NickTheWhale/lora-tracker/README.md

# lora-tracker
digikey cart: http://www.digikey.com/short/pwb05w9p
