NickTheWhale/lora-tracker/schematic gps.brd

## EAGLE design schematic gps.brd (2022-03-09)

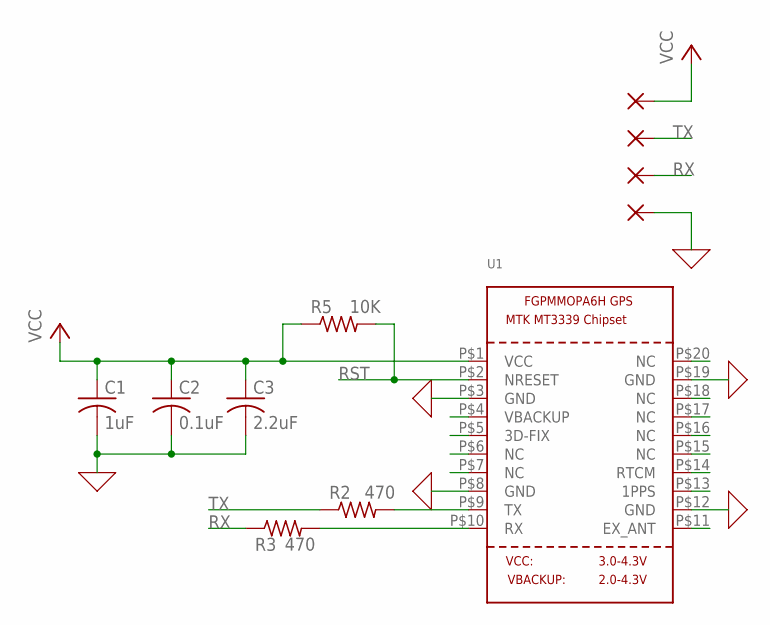
[picture p1: schematic schematic gps.sch]

Parts:
C1: 1uF; C0805
C2: 0.1uF; C0805
C3: 2.2uF; C0805
GND: WIREPADSMD1,27-254; SMD1,27-2,54
R2, R3: 470; R0805
R5: 10K; R0805
RX: WIREPADSMD1,27-254; SMD1,27-2,54
TX: WIREPADSMD1,27-254; SMD1,27-2,54
U1: GPS_FGPMMOPA6H; FGPMMOPA6H
VCC: WIREPADSMD1,27-254; SMD1,27-2,54

Connections:
0: C1.2, C2.2, C3.2, GND.1, U1.P$3 (GND), U1.P$8 (GND), U1.P$12 (GND), U1.P$19 (GND)
unnamed: R2.2, U1.P$9 (TX)
unnamed: R3.2, U1.P$10 (RX)
RST: R5.2, U1.P$2 (NRESET)
RX: R3.1, RX.1
TX: R2.1, TX.1
VCC: C1.1, C2.1, C3.1, R5.1, U1.P$1 (VCC), VCC.1

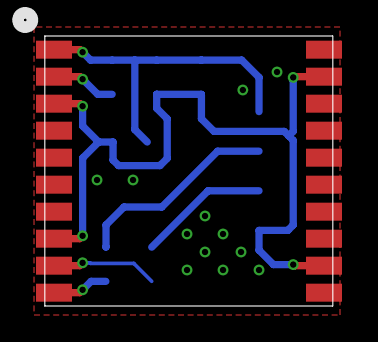
[picture p2: board schematic gps.brd from above]

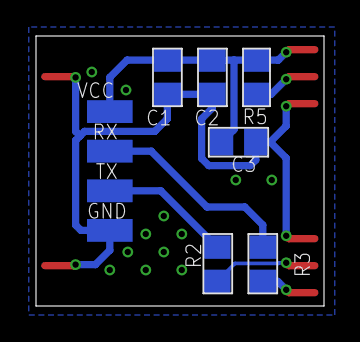
[picture p3: board schematic gps.brd from below]

Board: 2 copper layers, 16.0 x 15.0 mm, 11 parts (10 on the bottom side), 7 nets.
