NickTheWhale/lora-tracker/schematic.brd

## EAGLE design schematic.brd (2022-03-08)

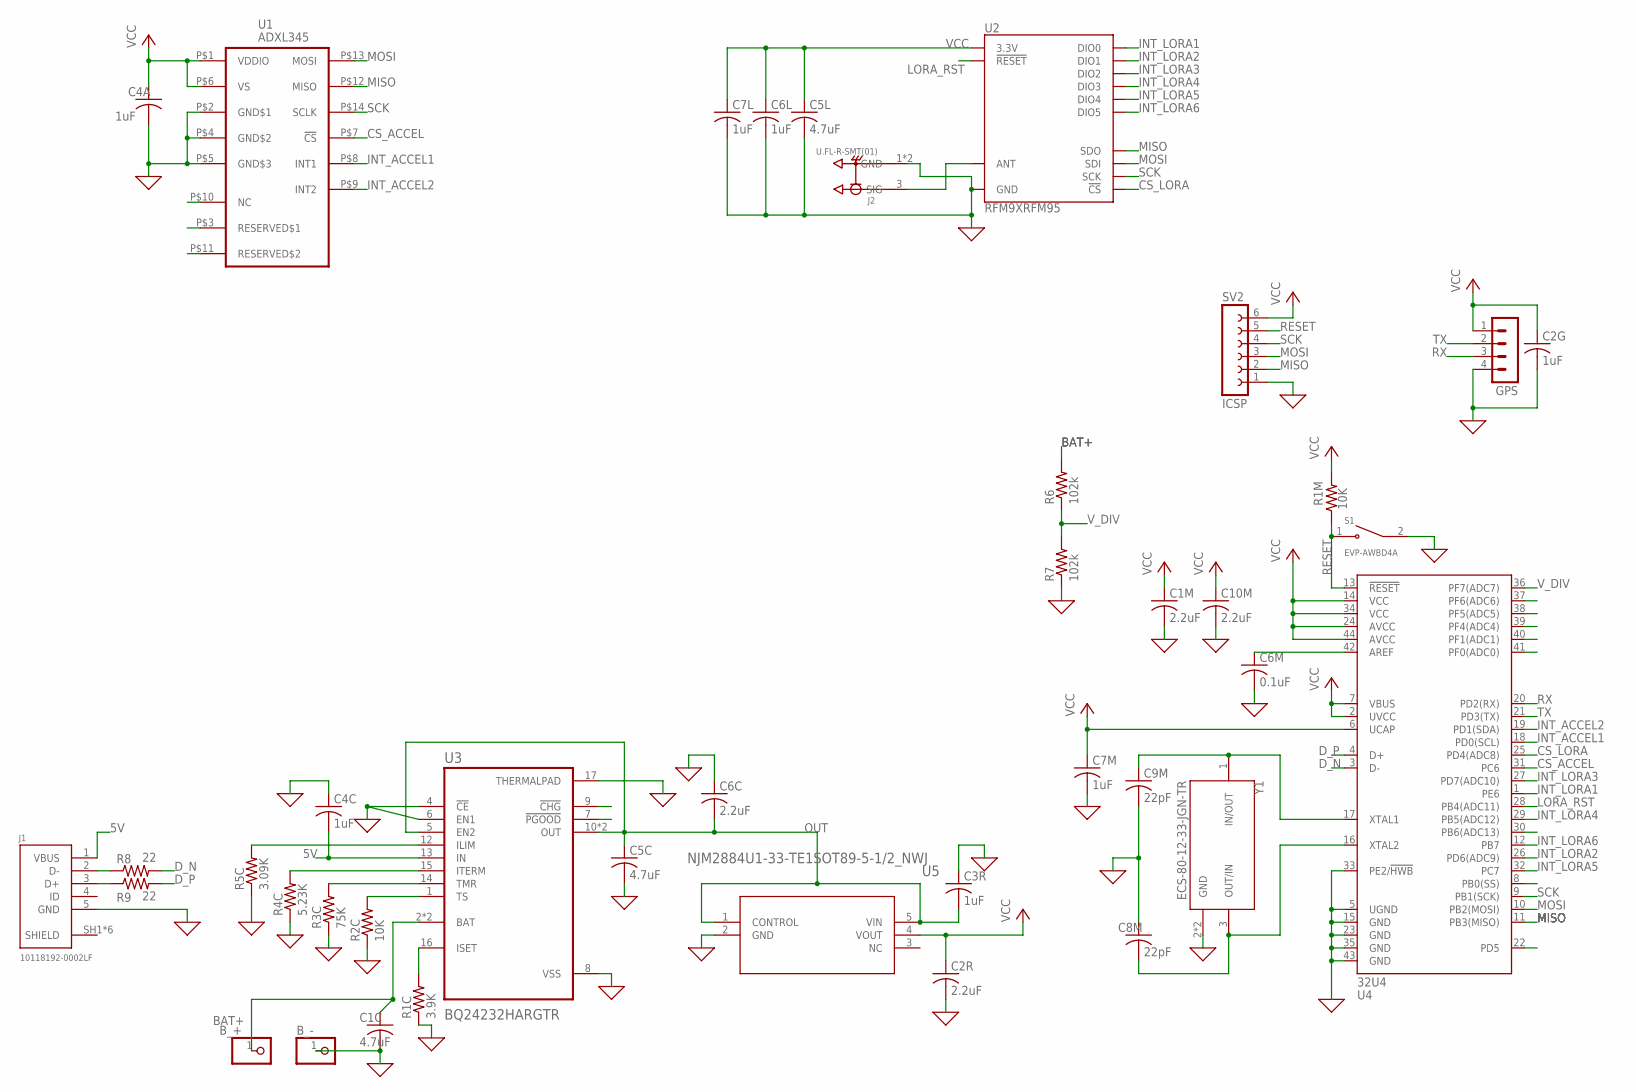
[picture p4: schematic schematic.sch]

Parts:
B_+: PINHD-1X1; 1X01
B_-: PINHD-1X1; 1X01
C1C, C5C, C5L: 4.7uF; C0805
C1M, C2R, C6C, C10M: 2.2uF; C0805
C2G, C3R, C4A, C4C, C6L, C7L, C7M: 1uF; C0805
C6M: 0.1uF; C0805
C8M, C9M: 22pF; C0805
GPS: MA04-1
J1: 10118192-0002LF
J2: U.FL-R-SMT(01); HRS_U.FL-R-SMT(01)
R1C: 3.9K; R0805
R1M, R2C: 10K; R0805
R3C: 75K; R0805
R4C: 5.23K; R0805
R5C: 3.09K; R0805
R6, R7: 102k; R0805
R8, R9: 22; R0805
S1: EVP-AWBD4A; SW_EVP-AWBD4A
SV2: ICSP; FE06
U1: ADXL345; LGA14
U2: RFM9XRFM95; RFM95
U3: BQ24232HARGTR; QFN50P300X300X100-17N
U4: 32U4; QFN-44
U5: NJM2884U1-33-TE1SOT89-5-1/2_NWJ; SOT89-5-1/2_NWJ
Y1: ECS-80-12-33-JGN-TR; XTAL_ECS-240-8-33-AGN-TR

Connections:
0: B_-.1, C1C.2, C1M.2, C2G.2, C2R.2, C3R.1, C4A.2, C4C.1, C5C.2, C5L.2, C6C.1, C6L.2, C6M.2, C7L.2, C7M.2, C8M.1, C9M.2, C10M.2, GPS.4, J1.5 (GND), J2.1 (GND), J2.2 (GND), R1C.1, R2C.1, R3C.1, R4C.1, R5C.1, R7.1, S1.2 (COM), SV2.1, U1.P$2 (GND$1), U1.P$4 (GND$2), U1.P$5 (GND$3), U2.GND@1 (GND), U2.GND@2 (GND), U2.GND@3 (GND), U3.4 (!CE), U3.6 (EN1), U3.8 (VSS), U3.17 (THERMALPAD), U4.5 (UGND), U4.15 (GND), U4.23 (GND), U4.33 (PE2/!HWB), U4.35 (GND), U4.43 (GND), U5.2 (GND), Y1.2 (GND), Y1.4 (GND)
5V: C4C.2, J1.1 (VBUS), U3.13 (IN)
BAT+: B_+.1, C1C.1, R6.2, U3.2 (BAT), U3.3 (BAT)
CS_ACCEL: U1.P$7 (!CS), U4.31 (PC6)
CS_LORA: U2.NSS (!CS!), U4.25 (PD4(ADC8))
D_N: R8.2, U4.3 (D-)
D_P: R9.2, U4.4 (D+)
INT_ACCEL1: U1.P$8 (INT1), U4.18 (PD0(SCL))
INT_ACCEL2: U1.P$9 (INT2), U4.19 (PD1(SDA))
INT_LORA1: U2.DIO0, U4.1 (PE6)
INT_LORA2: U2.DIO1, U4.26 (PD6(ADC9))
INT_LORA3: U2.DIO2, U4.27 (PD7(ADC10))
INT_LORA4: U2.DIO3, U4.29 (PB5(ADC12))
INT_LORA5: U2.DIO4, U4.32 (PC7)
INT_LORA6: U2.DIO5, U4.12 (PB7)
LORA_RST: U2.!RESET, U4.28 (PB4(ADC11))
MISO: SV2.2, U1.P$12 (MISO), U2.SDO, U4.11 (PB3(MISO))
MOSI: SV2.3, U1.P$13 (MOSI), U2.SDI, U4.10 (PB2(MOSI))
unnamed: J1.2 (D-), R8.1
unnamed: J1.3 (D+), R9.1
unnamed: R5C.2, U3.12 (ILIM)
unnamed: R4C.2, U3.15 (ITERM)
unnamed: R3C.2, U3.14 (TMR)
unnamed: J2.3 (SIG), U2.ANT
unnamed: R2C.2, U3.1 (TS)
unnamed: R1C.2, U3.16 (ISET)
unnamed: C8M.2, U4.16 (XTAL2), Y1.3 (OUT/IN)
unnamed: C9M.1, U4.17 (XTAL1), Y1.1 (IN/OUT)
unnamed: C6M.1, U4.42 (AREF)
OUT: C3R.2, C5C.1, C6C.2, U3.5 (EN2), U3.10 (OUT), U3.11 (OUT), U5.1 (CONTROL), U5.5 (VIN)
RESET: R1M.1, S1.1 (NO), SV2.5, U4.13 (!RESET)
RX: GPS.3, U4.20 (PD2(RX))
SCK: SV2.4, U1.P$14 (SCLK), U2.SCK, U4.9 (PB1(SCK))
SHIELD: J1.SH1 (SHIELD), J1.SH2 (SHIELD), J1.SH3 (SHIELD), J1.SH4 (SHIELD), J1.SH5 (SHIELD), J1.SH6 (SHIELD)
TX: GPS.2, U4.21 (PD3(TX))
VCC: C1M.1, C2G.1, C2R.1, C4A.1, C5L.1, C6L.1, C7L.1, C7M.1, C10M.1, GPS.1, R1M.2, SV2.6, U1.P$1 (VDDIO), U1.P$6 (VS), U2.3.3V, U4.2 (UVCC), U4.6 (UCAP), U4.7 (VBUS), U4.14 (VCC), U4.24 (AVCC), U4.34 (VCC), U4.44 (AVCC), U5.4 (VOUT)
V_DIV: R6.1, R7.2, U4.36 (PF7(ADC7))

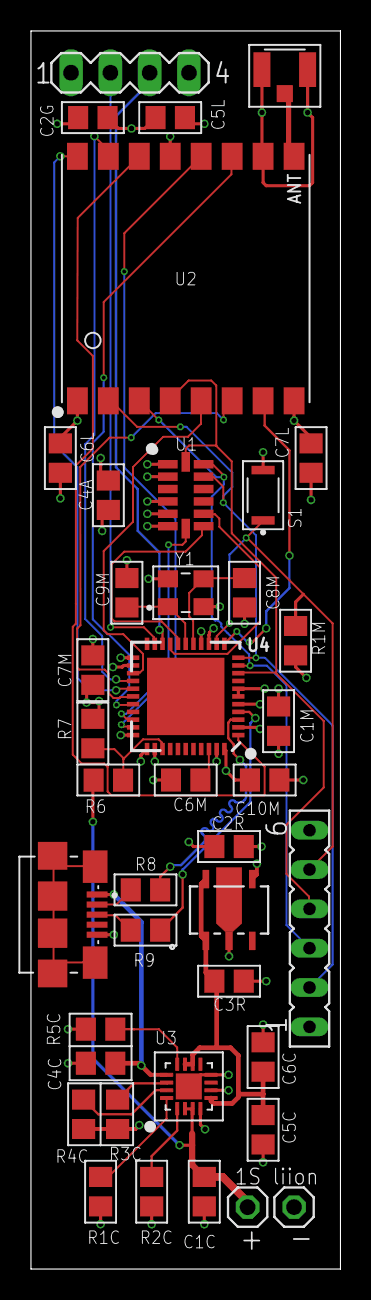
[picture p5: board schematic.brd from above]

Board: 4 copper layers, 20.0 x 80.0 mm, 40 parts (0 on the bottom side), 37 nets.
