NickTheWhale/lora-tracker/(notices)

Notices in the files:
parts and their libraries:
SparkFun-RF: Licensing: Creative Commons ShareAlike 4.0 International - https://creativecommons.org/licenses/by-sa/4.0
2021-10-22_20-54-43_Library: COPYRIGHT: Copyright (C) 2021 Ultra Librarian. All rights reserved.
